ktt-ol/door_bell_2.0/hardware/DG390-5.0-2p.STEP

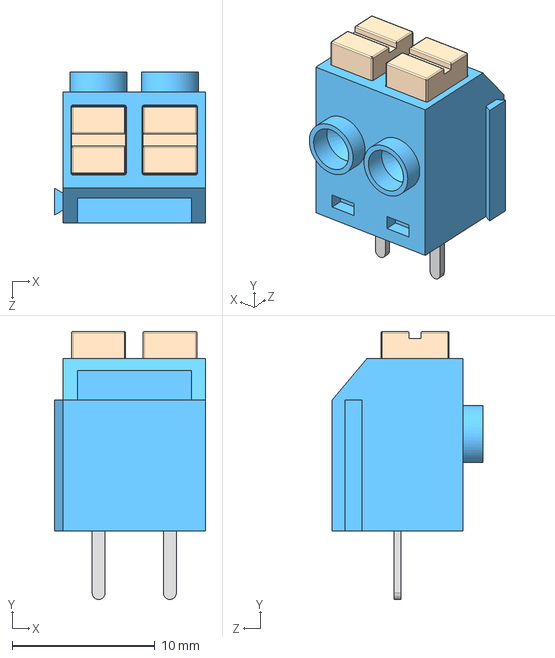
[picture p1: CAD file, 2024-01-23]
hardware/DG390-5.0-2p.STEP
10.6 x 18.8 x 10.6 mm
