ktt-ol/door_bell_2.0/hardware/esp32_max232.kicad_pcb

## KiCad design hardware/esp32_max232.kicad_pcb (2024-01-23)

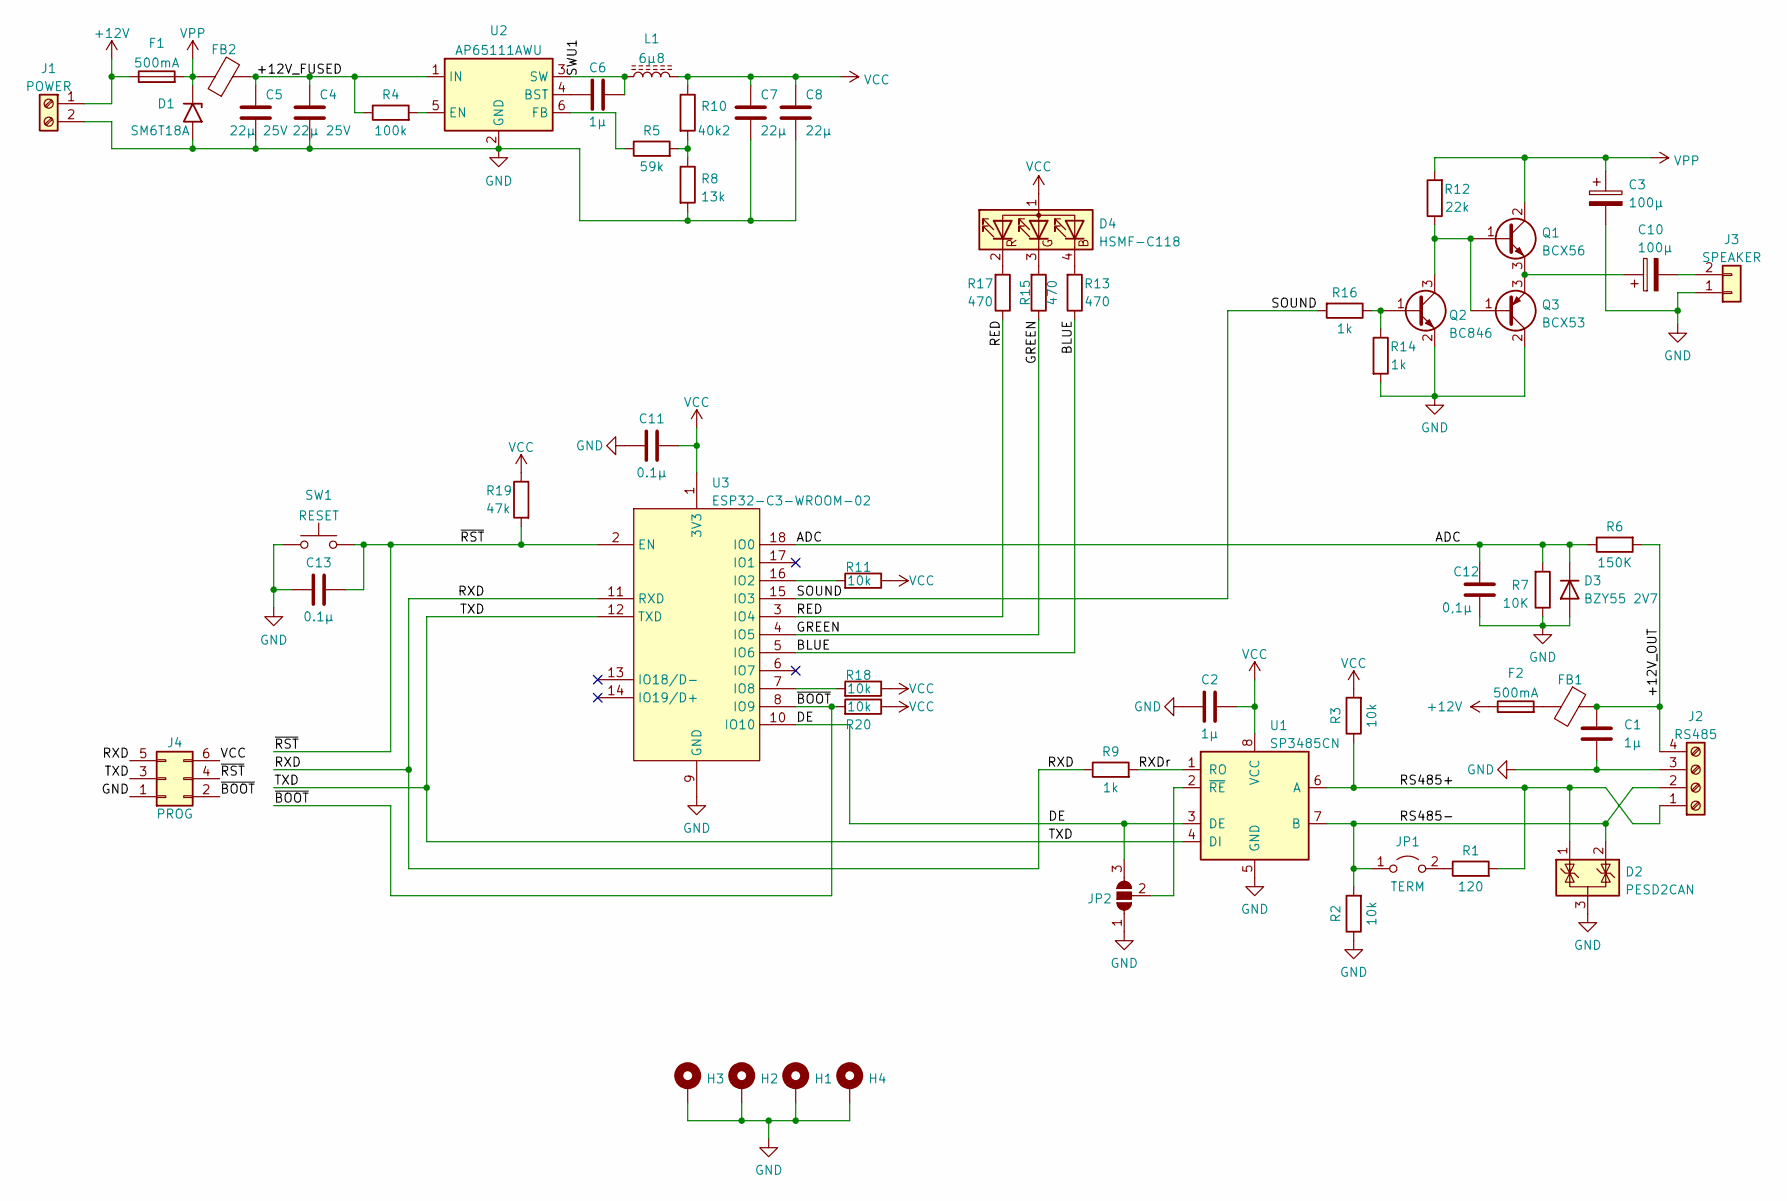
[picture p2: schematic esp32_max232.kicad_sch]

Parts:
C1, C2, C6: 1µ; C_0805_2012Metric
C3, C10: 100µ; CP_EIA-7343-31_Kemet-D
C4, C5: 22µ 25V; C_0805_2012Metric
C7, C8: 22µ; C_0805_2012Metric
C11, C13: 0.1µ; C_0805_2012Metric
C12: 0,1µ; C_0805_2012Metric
D1: SM6T18A; D_SMB
D2: PESD2CAN; SOT-23
D3: BZY55 2V7; D_0805_2012Metric
D4: HSMF-C118; LED_RGB_1210
F1, F2: 500mA; Fuse_0805_2012Metric_Pad1.15x1.40mm_HandSolder
FB1, FB2: FerriteBead; L_0805_2012Metric
H1, H2, H3, H4: MountingHole_Pad; MountingHole_3.2mm_M3_ISO7380_Pad_TopBottom
J1: POWER; TerminalBlock_RND_205-00001_1x02_P5.00mm_Horizontal
J2: RS485; TerminalBlock_RND_205-00003_1x04_P5.00mm_Horizontal
J3: SPEAKER; JST_EH_B2B-EH-A_1x02_P2.50mm_Vertical
J4: PROG; PinHeader_2x03_P2.54mm_Vertical
JP1: TERM; PinHeader_1x02_P2.54mm_Vertical
JP2: SolderJumper_3_Open; SolderJumper-3_P2.0mm_Open_TrianglePad1.0x1.5mm
L1: 6µ8; L_Taiyo-Yuden_NR-50xx
Q1: BCX56; SOT-89-3
Q2: BC846; SOT-23
Q3: BCX53; SOT-89-3
R1: 120; R_0805_2012Metric
R2, R3, R11, R18, R20: 10k; R_0805_2012Metric
R4: 100k; R_0805_2012Metric
R5: 59k; R_0805_2012Metric
R6: 150K; R_0805_2012Metric
R7: 10K; R_0805_2012Metric
R8: 13k; R_0805_2012Metric
R9, R14, R16: 1k; R_0805_2012Metric
R10: 40k2; R_0805_2012Metric
R12: 22k; R_0805_2012Metric
R13, R15, R17: 470; R_0805_2012Metric
R19: 47k; R_0805_2012Metric
SW1: RESET; SW_SPST_PTS810
U1: SP3485CN; SOIC-8_3.9x4.9mm_P1.27mm
U2: AP65111AWU; TSOT-23-6
U3: ESP32-C3-WROOM-02; ESP-WROOM-02

Connections:
+12V: F1.1, F2.1, J1.1
/+12V_FUSED: C4.1, C5.1, FB2.2, R4.1, U2.1 (IN)
/+12V_OUT: C1.2, FB1.1, J2.4, R6.2
/ADC: C12.1, D3.1 (K), R6.1, R7.2, U3.18 (IO0)
/BLUE: R13.1, U3.5 (IO6)
/DE: JP2.3 (B), U1.3 (DE), U3.10 (IO10)
/GREEN: R15.1, U3.4 (IO5)
/RED: R17.1, U3.3 (IO4)
/RS485+: D2.1 (K), J2.1, R1.2, R3.1, U1.6 (A)
/RS485-: D2.2 (K), J2.2, JP1.1 (A), R2.2, U1.7 (B)
/RXD: J4.5, R9.1, U3.11 (RXD)
/RXDr: R9.2, U1.1 (RO)
/SOUND: R16.2, U3.15 (IO3)
/SWU1: C6.2, L1.1, U2.3 (SW)
/TXD: J4.3, U1.4 (DI), U3.12 (TXD)
/~BOOT: J4.2, R20.2, U3.8 (IO9)
/~RST: C13.1, J4.4, R19.2, SW1.1, U3.2 (EN)
GND: C1.1, C2.2, C3.2, C4.2, C5.2, C7.2, C8.2, C11.2, C12.2, C13.2, D1.2 (A2), D2.3 (A), D3.2 (A), H1.1, H2.1, H3.1, H4.1, J1.2, J2.3, J3.1, J4.1, JP2.1 (A), Q2.2 (E), Q3.2 (C), R2.1, R7.1, R8.2, R14.2, SW1.2, U1.5 (GND), U2.2 (GND), U3.9 (GND), U3.19 (GND)
unnamed: C6.1, U2.4 (BST)
unnamed: C10.1, Q1.3 (E), Q3.3 (E)
unnamed: C10.2, J3.2
unnamed: D4.2 (RK), R17.2
unnamed: D4.3 (GK), R15.2
unnamed: D4.4 (BK), R13.2
unnamed: F2.2, FB1.2
unnamed: JP1.2 (B), R1.1
unnamed: JP2.2 (C), U1.2 (~RE)
unnamed: Q1.1 (B), Q2.3 (C), Q3.1 (B), R12.1
unnamed: Q2.1 (B), R14.1, R16.1
unnamed: R4.2, U2.5 (EN)
unnamed: R5.1, U2.6 (FB)
unnamed: R5.2, R8.1, R10.2
unnamed: R11.2, U3.16 (IO2)
unnamed: R18.2, U3.7 (IO8)
VCC: C2.1, C7.1, C8.1, C11.1, D4.1 (A), J4.6, L1.2, R3.2, R10.1, R11.1, R18.1, R19.1, R20.1, U1.8 (VCC), U3.1 (3V3)
VPP: C3.1, D1.1 (A1), F1.2, FB2.1, Q1.2 (C), R12.2

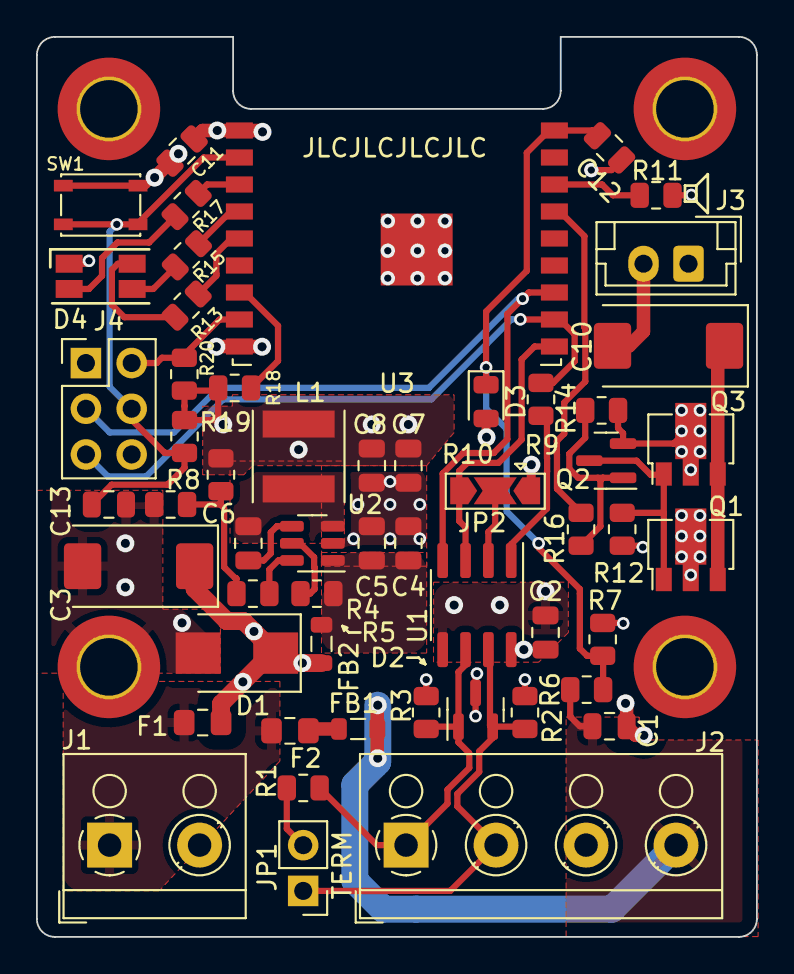
[picture p3: board esp32_max232.kicad_pcb from above]

Board: 4 copper layers, 40.0 x 50.0 mm, 58 parts (0 on the bottom side), 36 nets.
