ktt-ol/door_bell_2.0/(commit log)

2023-10-24 Refactor LED handling
2023-10-24 Increase timer size up to 64 bit
2023-11-04 Observe MQTT status failures
    [bell20_esp32.ino]
2024-01-23 Add hardware project
    [DG390-5.0-2p.STEP, esp32_max232.kicad_pcb, esp32_max232.kicad_sch]
